alexpaschoaletto/robot-vehicle/Raspberry/pegasoboard.h

#ifndef pegasoboard_pins_h
#define pegasoboard_pins_h

#define DIR_BASE 0
#define STEP_BASE 1

#define DIR_A 2
#define STEP_A 3

#define DIR_B 4
#define STEP_B 5

#define DIR_C 6
#define STEP_C 7

#define DIR_D 8
#define STEP_D 9

#define DIR_E 11
#define STEP_E 10

#define MISO 12
#define CS 13
#define SCK 14
#define MOSI 15

#define UART_TX 16
#define UART_RX 17

#define EN 19
#define RST 20
#define SLP 21

#define SDA 26
#define SCL 27

#define M0 28 
#define M1 22
#define M2 18

#endif
